LEP-PEA-EPUSP/OpenSourcePowerElectronics-HW-Inverter-2026/README.md

# OpenSourcePowerElectronics-HW-Inverter-2026

This repository contains the manuals, schematics, layout and testing programs necessary to build and operate the inverter module of the platform.
