LEP-PEA-EPUSP/OpenSourcePowerElectronics-HW-Inverter-2026/Others/Test-GPIO - Inversora-20230306T224831Z-001/Test-GPIO - Inversora/Documentação.docx

Créditos do programa e documentação inicial: Thiago Lima

Descrição e instruções de uso

Este programa é uma versão reduzida do programa “Test_GPIO”, cujo é testar as saídas digitais da placa processadora conectadas ao “header” da placa inversora. A rotina de testes está descrita abaixo:

i) Carregar o programa usando o debugger;
ii) Avançar de linha a linha, pausando o programa e medindo com um multímetro os pinos necessários.

Pontos importantes do código

Reseta todas as saídas digitais

//Inverter Board Header

HAL_GPIO_WritePin(GPIOE, GPIO_PIN_9, GPIO_PIN_RESET);

HAL_GPIO_WritePin(GPIOE, GPIO_PIN_11, GPIO_PIN_RESET);

HAL_GPIO_WritePin(GPIOE, GPIO_PIN_13, GPIO_PIN_RESET);

HAL_GPIO_WritePin(GPIOE, GPIO_PIN_14, GPIO_PIN_RESET);

HAL_GPIO_WritePin(GPIOE, GPIO_PIN_15, GPIO_PIN_RESET);

Ativa e desativa todas as saídas digitais

///////////////////////////////////////////////////////////////////

HAL_Delay(2000); //espera 5000 unidades de tempo

HAL_GPIO_WritePin(GPIOE, GPIO_PIN_9, GPIO_PIN_SET); //Set PE9

HAL_Delay(2000); //espera 5000 unidades de tempo

HAL_GPIO_WritePin(GPIOE, GPIO_PIN_9, GPIO_PIN_RESET); //Reset PE9

///////////////////////////////////////////////////////////////////

HAL_Delay(2000); //espera 5000 unidades de tempo

HAL_GPIO_WritePin(GPIOE, GPIO_PIN_11, GPIO_PIN_SET); //Set PE11

HAL_Delay(2000); //espera 5000 unidades de tempo

HAL_GPIO_WritePin(GPIOE, GPIO_PIN_11, GPIO_PIN_RESET); //Reset PE11

///////////////////////////////////////////////////////////////////

HAL_Delay(2000); //espera 5000 unidades de tempo

HAL_GPIO_WritePin(GPIOE, GPIO_PIN_13, GPIO_PIN_SET); //Set PE13

HAL_Delay(2000); //espera 5000 unidades de tempo

HAL_GPIO_WritePin(GPIOE, GPIO_PIN_13, GPIO_PIN_RESET); //Reset PE13

///////////////////////////////////////////////////////////////////

HAL_Delay(2000); //espera 5000 unidades de tempo

HAL_GPIO_WritePin(GPIOE, GPIO_PIN_14, GPIO_PIN_SET); //Set PE14

HAL_Delay(2000); //espera 5000 unidades de tempo

HAL_GPIO_WritePin(GPIOE, GPIO_PIN_14, GPIO_PIN_RESET); //Reset PE14

///////////////////////////////////////////////////////////////////

HAL_Delay(2000); //espera 5000 unidades de tempo

HAL_GPIO_WritePin(GPIOE, GPIO_PIN_15, GPIO_PIN_SET); //Set PE15

HAL_Delay(2000); //espera 5000 unidades de tempo

HAL_GPIO_WritePin(GPIOE, GPIO_PIN_15, GPIO_PIN_RESET); //Reset PE15

///////////////////////////////////////////////////////////////////

Mapa de Pinos
