LEP-PEA-EPUSP/OpenSourcePowerElectronics-HW-Inverter-2026/(list of files, drawings)

Other design files:
Schematics and Layouts/placa-VNM-15-12-20.pdsprj
