LEP-PEA-EPUSP/OpenSourcePowerElectronics-HW-Inverter-2026/Others/Test-GPIO - Inversora-20230306T224831Z-001/Test-GPIO - Inversora/Core/Src/main.c

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
/* Includes ------------------------------------------------------------------*/
#include "main.h"


void SystemClock_Config(void);
static void MX_GPIO_Init(void);
/**
  * @brief  The application entry point.
  * @retval int
  */
int main(void)
{
  /* MCU Configuration--------------------------------------------------------*/

  /* Reset of all peripherals, Initializes the Flash interface and the Systick. */
  HAL_Init();

  /* Configure the system clock */
  SystemClock_Config();

  /* Initialize all configured peripherals */
  MX_GPIO_Init();
  /* USER CODE BEGIN 2 */
  //Reset all pins



  //Inverter Board Header
  HAL_GPIO_WritePin(GPIOE, GPIO_PIN_9, GPIO_PIN_RESET);
  HAL_GPIO_WritePin(GPIOE, GPIO_PIN_11, GPIO_PIN_RESET);
  HAL_GPIO_WritePin(GPIOE, GPIO_PIN_13, GPIO_PIN_RESET);
  HAL_GPIO_WritePin(GPIOE, GPIO_PIN_14, GPIO_PIN_RESET);
  HAL_GPIO_WritePin(GPIOE, GPIO_PIN_15, GPIO_PIN_RESET);



  /* USER CODE END 2 */

  /* Infinite loop */
  /* USER CODE BEGIN WHILE */
  while (1)
  {
	  // Versão para testes da placa inversora!
	  ///////////////////////////////////////////////////////////////////

	  int timer = 2000; //define o tempo dos delays

	  HAL_Delay(timer); //espera unidades de tempo
	  HAL_GPIO_WritePin(GPIOE, GPIO_PIN_9, GPIO_PIN_SET); //Set PE9
	  HAL_Delay(timer); //espera unidades de tempo
	  HAL_GPIO_WritePin(GPIOE, GPIO_PIN_9, GPIO_PIN_RESET); //Reset PE9

	  ///////////////////////////////////////////////////////////////////

	  HAL_Delay(timer); //espera unidades de tempo
	  HAL_GPIO_WritePin(GPIOE, GPIO_PIN_11, GPIO_PIN_SET); //Set PE11
	  HAL_Delay(timer); //espera unidades de tempo
	  HAL_GPIO_WritePin(GPIOE, GPIO_PIN_11, GPIO_PIN_RESET); //Reset PE11

	  ///////////////////////////////////////////////////////////////////

	  HAL_Delay(timer); //espera unidades de tempo
	  HAL_GPIO_WritePin(GPIOE, GPIO_PIN_13, GPIO_PIN_SET); //Set PE13
	  HAL_Delay(timer); //espera unidades de tempo
	  HAL_GPIO_WritePin(GPIOE, GPIO_PIN_13, GPIO_PIN_RESET); //Reset PE13

	  ///////////////////////////////////////////////////////////////////

	  HAL_Delay(timer); //espera unidades de tempo
	  HAL_GPIO_WritePin(GPIOE, GPIO_PIN_14, GPIO_PIN_SET); //Set PE14
	  HAL_Delay(timer); //espera unidades de tempo
	  HAL_GPIO_WritePin(GPIOE, GPIO_PIN_14, GPIO_PIN_RESET); //Reset PE14

	  ///////////////////////////////////////////////////////////////////

	  HAL_Delay(timer); //espera unidades de tempo
	  HAL_GPIO_WritePin(GPIOE, GPIO_PIN_15, GPIO_PIN_SET); //Set PE15
	  HAL_Delay(timer); //espera unidades de tempo
	  HAL_GPIO_WritePin(GPIOE, GPIO_PIN_15, GPIO_PIN_RESET); //Reset PE15

	  ///////////////////////////////////////////////////////////////////

	  //espera 5000 unidades de tempo
	  HAL_Delay(5000);

    /* USER CODE END WHILE */


    /* USER CODE BEGIN 3 */
  }
  /* USER CODE END 3 */
}

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
