LEP-PEA-EPUSP/OpenSourcePowerElectronics-HW-Inverter-2026/Others/Teste-Optos-Inversora-20230306T224859Z-001/Teste-Optos-Inversora/Teste-Optos-Inversora.ioc

Mcu.UserName=STM32F407VGTx
PA0-WKUP.GPIO_Label=B1 [Blue PushButton]
PA0-WKUP.Signal=GPXTI0
PA10.GPIO_Label=OTG_FS_ID
PA10.Signal=USB_OTG_FS_ID
PA11.GPIO_Label=OTG_FS_DM
PA11.Signal=USB_OTG_FS_DM
PA12.GPIO_Label=OTG_FS_DP
PA12.Signal=USB_OTG_FS_DP
PA13.GPIO_Label=SWDIO
PA13.Signal=SYS_JTMS-SWDIO
PA14.GPIO_Label=SWCLK
PA14.Signal=SYS_JTCK-SWCLK
PA4.GPIO_Label=I2S3_WS [CS43L22_LRCK]
PA4.Signal=I2S3_WS
PA5.GPIO_Label=SPI1_SCK [LIS302DL_SCL/SPC]
PA5.Signal=SPI1_SCK
PA6.GPIO_Label=SPI1_MISO [LIS302DL_SDO]
PA6.Signal=SPI1_MISO
PA7.GPIO_Label=SPI1_MOSI [LIS302DL_SDA/SDI/SDO]
PA7.Signal=SPI1_MOSI
PA9.GPIO_Label=VBUS_FS
PA9.Signal=USB_OTG_FS_VBUS
PB10.GPIO_Label=CLK_IN [MP45DT02_CLK]
PB10.Signal=I2S2_CK
PB2.GPIO_Label=BOOT1
PB2.Signal=GPIO_Input
PB3.GPIO_Label=SWO
PB3.Signal=SYS_JTDO-SWO
PB6.GPIO_Label=Audio_SCL [CS43L22_SCL]
PB6.Signal=I2C1_SCL
PB9.GPIO_Label=Audio_SDA [CS43L22_SDA]
PB9.Signal=I2C1_SDA
PC0.GPIO_Label=OTG_FS_PowerSwitchOn
PC0.Signal=GPIO_Output
PC10.GPIO_Label=I2S3_SCK [CS43L22_SCLK]
PC10.Signal=I2S3_CK
PC12.GPIO_Label=I2S3_SD [CS43L22_SDIN]
PC12.Signal=I2S3_SD
PC14-OSC32_IN.GPIO_Label=PC14-OSC32_IN
PC14-OSC32_IN.Signal=RCC_OSC32_IN
PC15-OSC32_OUT.GPIO_Label=PC15-OSC32_OUT
PC15-OSC32_OUT.Signal=RCC_OSC32_OUT
PC3.GPIO_Label=PDM_OUT [MP45DT02_DOUT]
PC3.Signal=I2S2_SD
PC7.GPIO_Label=I2S3_MCK [CS43L22_MCLK]
PC7.Signal=I2S3_MCK
PD12.GPIO_Label=LD4 [Green Led]
PD12.Signal=GPIO_Output
PD13.GPIO_Label=LD3 [Orange Led]
PD13.Signal=GPIO_Output
PD14.GPIO_Label=LD5 [Red Led]
PD14.Signal=GPIO_Output
PD15.GPIO_Label=LD6 [Blue Led]
PD15.Signal=GPIO_Output
PD4.GPIO_Label=Audio_RST [CS43L22_RESET]
PD4.Signal=GPIO_Output
PD5.GPIO_Label=OTG_FS_OverCurrent
PD5.Signal=GPIO_Input
PE1.GPIO_Label=MEMS_INT2 [LIS302DL_INT2]
PE1.Signal=GPXTI1
PE3.GPIO_Label=CS_I2C/SPI [LIS302DL_CS_I2C/SPI]
PE3.Signal=GPIO_Output
PH0-OSC_IN.GPIO_Label=PH0-OSC_IN
PH0-OSC_IN.Signal=RCC_OSC_IN
PH1-OSC_OUT.GPIO_Label=PH1-OSC_OUT
PH1-OSC_OUT.Signal=RCC_OSC_OUT
